chipKIT32/RGB_Station/README.md

# RGB_Station
RGB Station project - remix of Fubarino Mini + addressable LEDs + BLE
