chipKIT32/RGB_Station/board_v12/RGB_Station_v12_BOM_Microchip.xlsx

Sheet: BOM Report
Bill of Materials |  | Bill of Materials For Project RGB Station
Part Number:
Revision: | 1.2
Engineer: | Brian Schmalz
Drawn By: | Brian Schmalz
Creation Date:
Print Date:
Quantity | Designator | Description | Manufacturer 1 | Manufacturer Part Number 1 | Supplier 1 | Supplier Part Number 1 | RoHS compliant? | Supplier Order Qty 1 | Supplier Unit Price 1 | Extension
1 | U4 | OSC MEMS 8.0000MHZ CMOS SMD | Microchip | DSC6111CI1A-008.0000 | Digi-Key | DSC6111CI1A-008.0000-ND | Yes | 1 | $0.88 | $0.88
1 | IC1 | IC REG SOT89 3.3V | Microchip | MCP1702T-3302E/MB | Digi-Key | MCP1702T-3302E/MBCT-ND | Yes | 1 | $0.50 | $0.50
2 | C2, C3 | CAP 1UF 10V CER Y5V SMD 0603 | Kemet | C0603C105Z8VACTU | Digi-Key | 399-3216-1-ND | Yes | 1 | $0.10 | $0.10
3 | C5, C12, C13 | CAP CER 10UF 10V Y5V 0805 | Samsung | CL21F106ZPFNNNE | Digi-Key | 1276-3012-1-ND | Yes | 3 | $0.15 | $0.45
1 | J3 | CONN RCPT USB MICRO B R/A SMT | Wurth Electronics Inc. (https://www.digikey.com/en/supplier-centers/w/wurth-electronics) | 629105136821 | Digi-Key | 732-3155-1-ND | Yes | 1 | $1.21 | $1.21
2 | SW1, SW2 | SWITCH TACTILE SPST-NO 0.05A 32V | C&K Components | KMR221GLFS | Digi-Key | 401-1427-1-ND | Yes | 2 | $0.51 | $1.02
7 | C4, C6, C7, C8, C9, C10, C14 | CAP CER 0.1UF 50V X7R 0603 | Murata | GCJ188R71H104KA12D | Digi-Key | 490-5798-1-ND | Yes | 8 | $0.14 | $1.12
1 | LED1 | LED RED CLEAR 0603 SMD | Dialight | 5988020107F | Digi-Key | 350-2030-1-ND | Yes | 1 | $0.51 | $0.51
1 | LED2 | LED GREEN CLEAR 0603 SMD | Wurth Electronics | 150060GS75000 | Digi-Key | 732-4971-1-ND | Yes | 1 | $0.22 | $0.22
3 | R4,R8,R11 | RES SMD 8.2K OHM 5% 1/10W 0603 | Stackpole | RMCF0603JT8K20 | Digi-Key | RMCF0603JT8K20CT-ND | Yes | 3 | $0.10 | $0.30
3 | R1,R9,R10 | RES 10K OHM 1/10W 5% 0603 SMD | Stackpole | RMCF0603JT10K0 | Digi-Key | RMCF0603JT10K0CT-ND | Yes | 3 | $0.10 | $0.30
1 | U1 | PIC32 USB CPU | Microchip | PIC32MX270F256D-50I/ML | Digi-Key | PIC32MX270F256D-50I/ML-ND | Yes | 1 | $4.69 | $4.69
1 | LED3 | LED BLUE CLEAR 0603 SMD | Wurth Electronics | 150060BS75000 | Digi-Key | 732-4966-1-ND | Yes | 1 | $0.15 | $0.15
1 |  | RGB Station v1.2 blank PCB | SeeedStudios | N.A. | SeeedStudios | N.A. | Yes | 1 |  | $0.00
1 | U2 | IC BUS TRANSCVR 2B N-INV US8 | Texas Instur (https://www.digikey.com/en/supplier-centers/n/nexperia) | SN74LVC2T45DCUR | Digi-Key | 296-17014-1-ND | Yes | 1 | $0.61 | $0.61
1 | U6 | BLUETOOTH 4.2 BLE MODULE, SHIELD | Microchip | RN4871-V/RM118 | Digi-Key | RN4871-V/RM118-ND | Yes | 1 | $7.38 | $7.38
1 | U3 | IC SUPERVISOR 3.08V LOW SOT-23B | Microchip | MCP131T-315E/TT | MicrochipDirect | MCP131T-315E/TTCT-ND | Yes | 1 | $0.53 | $0.53
1 | C11 | CAP ALUM 100UF 20% 10V SMD | Panasonic | EEE-1AA101WR | Digi-Key | PCE3867CT-ND | Yes | 1 | $0.31 | $0.31
2 | R2, R3 | RES SMD 100 OHM 5% 1/10W 0603 | Stackpole | RMCF0603JT100R | Digi-Key | RMCF0603JT100RCT-ND | Yes | 2 | $0.10 | $0.20
DO NOT POPULATE ANY PARTS BELOW THIS LINE
0 | J7 | 4-pin .100" header
0 | J1, J2 | 20-pin .100" header
0 | J6 | CONN TERM BLOCK T/H 2POS 3.5MM | Phoenix Contact | 1984617 | Digi-Key | 277-1721-ND | Yes | 1 | $0.43 | $0.43
0 | J5 | CONN TERM BLOCK T/H 4POS 3.5MM | Phoenix Contact | 1984633 | Digi-Key | 277-1860-ND | Yes | 1 | $0.85 | $0.85
0 | J3 | 5-pin .100" header
 |  |  |  |  |  |  |  |  |  | $21.76
Approved | Notes

Sheet: Project Information
Project Full Path
Project Filename
Variant Name
Data-Source Filename
Data-Source Full Path
Title
Total Quantity
Report Time
Report Date
Report Date & Tine
Output Name
Output Type
Output Generator Name
Output Generator Description

Sheet: Compatibility Report
Compatibility Report for RGB_Station_v10_BOM_Microchip.xls
Run on 11/17/2017 3:42
If the workbook is saved in an earlier file format or opened in an earlier version of Microsoft Excel, the listed features will not be available.
Minor loss of fidelity | # of occurrences | Version
Some cells or styles in this workbook contain formatting that is not supported by the selected file format. These formats will be converted to the closest format available. | 1 | Excel 97-2003
