chipKIT32/RGB_Station/docs/RGB_station_PinDiagram_v12.pdf

# RGB Station v1.2 pins

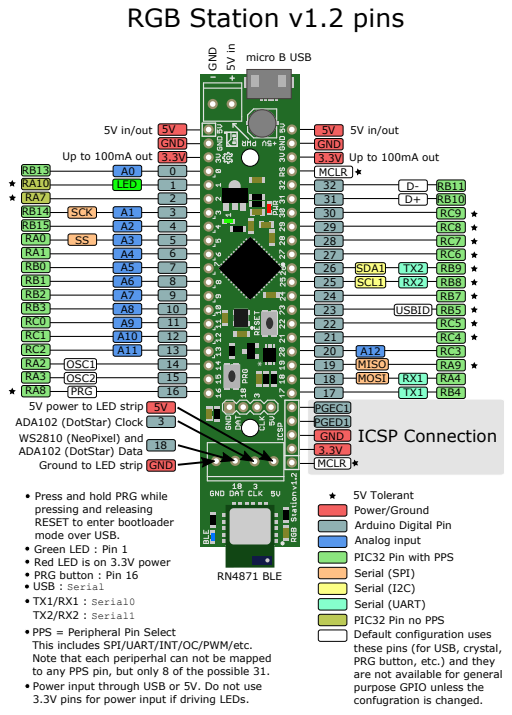
[picture p1: page 1]
micro B USB; ICSP Connection; GND; MCLR 32 31 30 29 28 27 26 25 24 23 22 21 20 19 18 17; SCK; OSC1 OSC2 PRG; MOSI; MISO; USBID; SDA1; SCL1; 5V in/out; Up to 100mA out; MCLR; PGED1; PGEC1; LED; 5V power to LED strip 5V; Ground to LED strip; ADA102 (DotStar) Clock WS2810 (NeoPixel) and ADA102 (DotStar) Data; RN4871 BLE

Up to 100mA out

Press and hold PRG while
pressing and releasing
RESET to enter bootloader
mode over USB.
Green LED : Pin 1
Red LED is on 3.3V power
PRG button : Pin 16
USB : Serial
TX1/RX1 : Serial0
TX2/RX2 : Serial1
PPS = Peripheral Pin Select
This includes SPI/UART/INT/OC/PWM/etc.
Note that each periperhal can not be mapped
to any PPS pin, but only 8 of the possible 31.
Power input through USB or 5V. Do not use
3.3V pins for power input if driving LEDs.

5V Tolerant
Power/Ground
Arduino Digital Pin
Analog input
PIC32 Pin with PPS
Serial (SPI)
Serial (I2C)
Serial (UART)
PIC32 Pin no PPS
Default configuration uses
these pins (for USB, crystal,
PRG button, etc.) and they
are not available for general
purpose GPIO unless the
confugration is changed.
