chipKIT32/RGB_Station/board_v12/RGB_Station_v12_sch.pdf

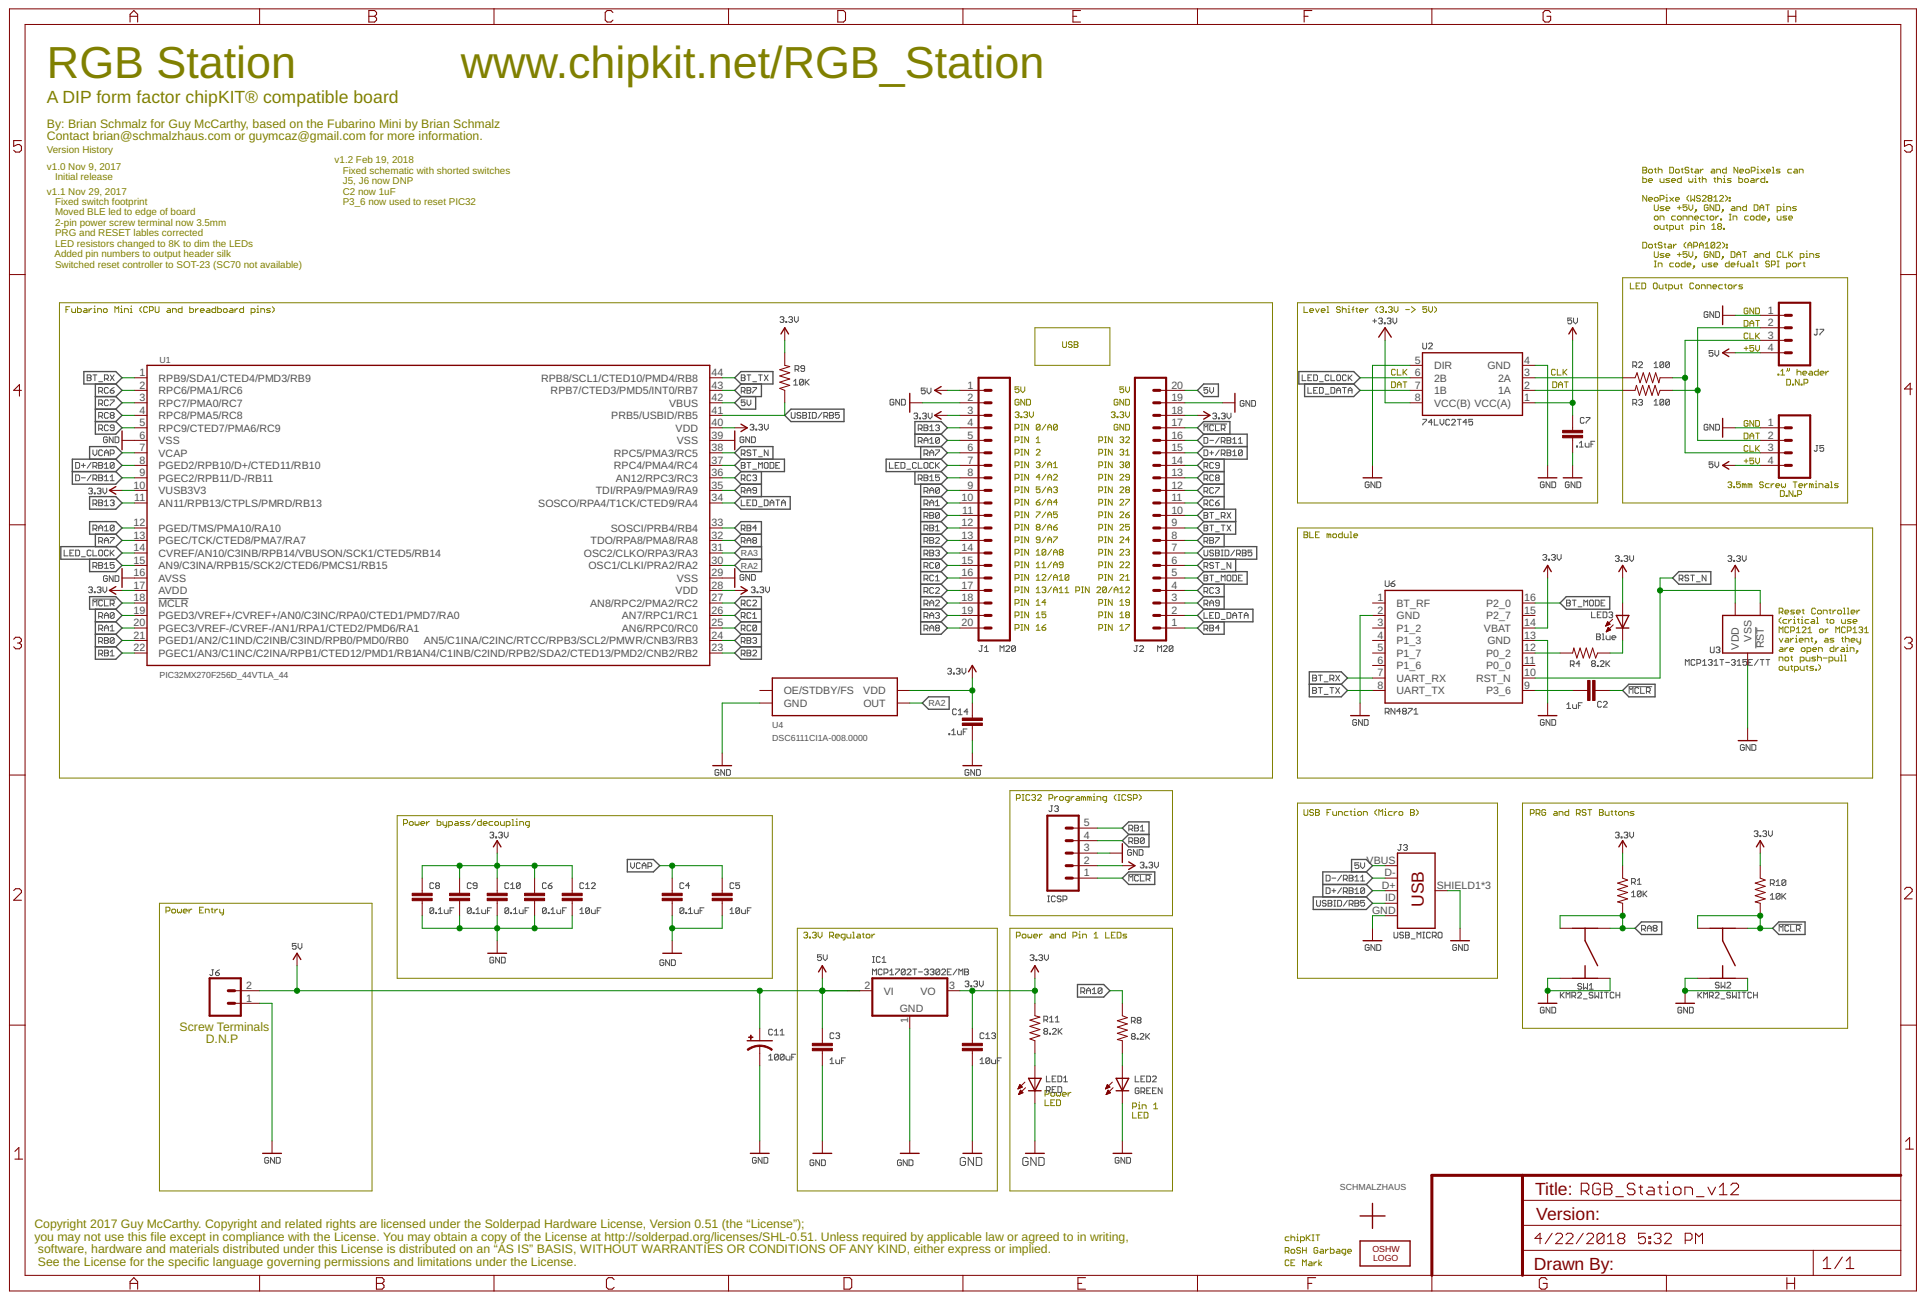
[picture p2: page 1]

Initial release Version History A DIP form factor chipKIT® compatible board

By: Brian Schmalz for Guy McCarthy, based on the Fubarino Mini by Brian Schmalz Contact brian@schmalzhaus.com or guymcaz@gmail.com for more information. v1.0 Nov 9, 2017

v1.2 Feb 19, 2018 Fixed schematic with shorted switches

v1.1 Nov 29, 2017 Fixed switch footprint Moved BLE led to edge of board

J5, J6 now DNP C2 now 1uF P3_6 now used to reset PIC32

2-pin power screw terminal now 3.5mm
PRG and RESET lables corrected
LED resistors changed to 8K to dim the LEDs Added pin numbers to output header silk Switched reset controller to SOT-23 (SC70 not available)

Drawn By: Title: Version: OSHW

Copyright 2017 Guy McCarthy. Copyright and related rights are licensed under the Solderpad Hardware License, Version 0.51 (the “License”); you may not use this file except in compliance with the License. You may obtain a copy of the License at http://solderpad.org/licenses/SHL-0.51. Unless required by applicable law or agreed to in writing, software, hardware and materials distributed under this License is distributed on an “AS IS” BASIS, WITHOUT WARRANTIES OR CONDITIONS OF ANY KIND, either express or implied. See the License for the specific language governing permissions and limitations under the License.
