chipKIT32/RGB_Station/docs/RGB_Station_v12_brd.pdf

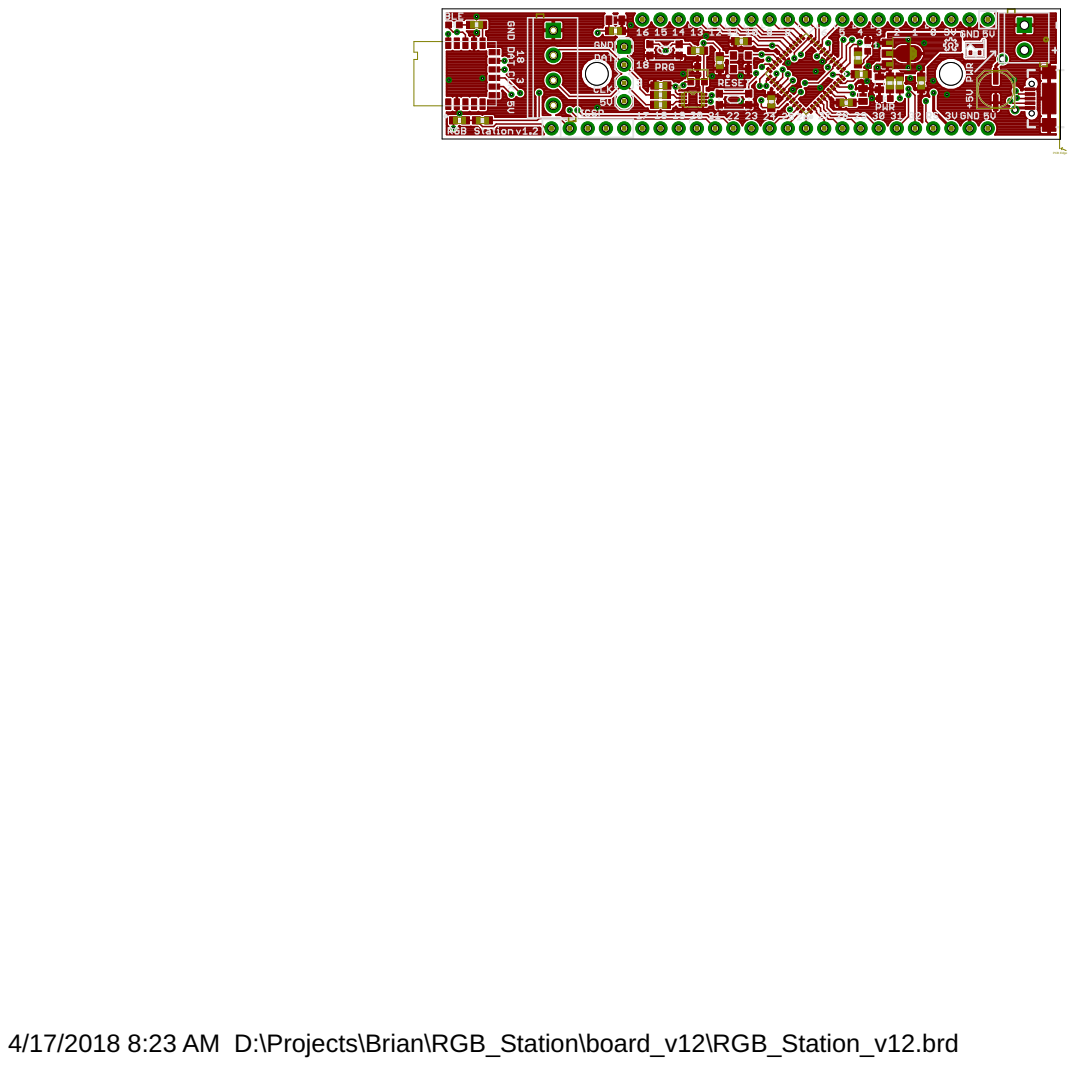
[picture p3: page 1]

4/17/2018 8:23 AM D:\Projects\Brian\RGB_Station\board_v12\RGB_Station_v12.brd
