chipKIT32/RGB_Station/board_v11/RGB_Station_v11.pdf

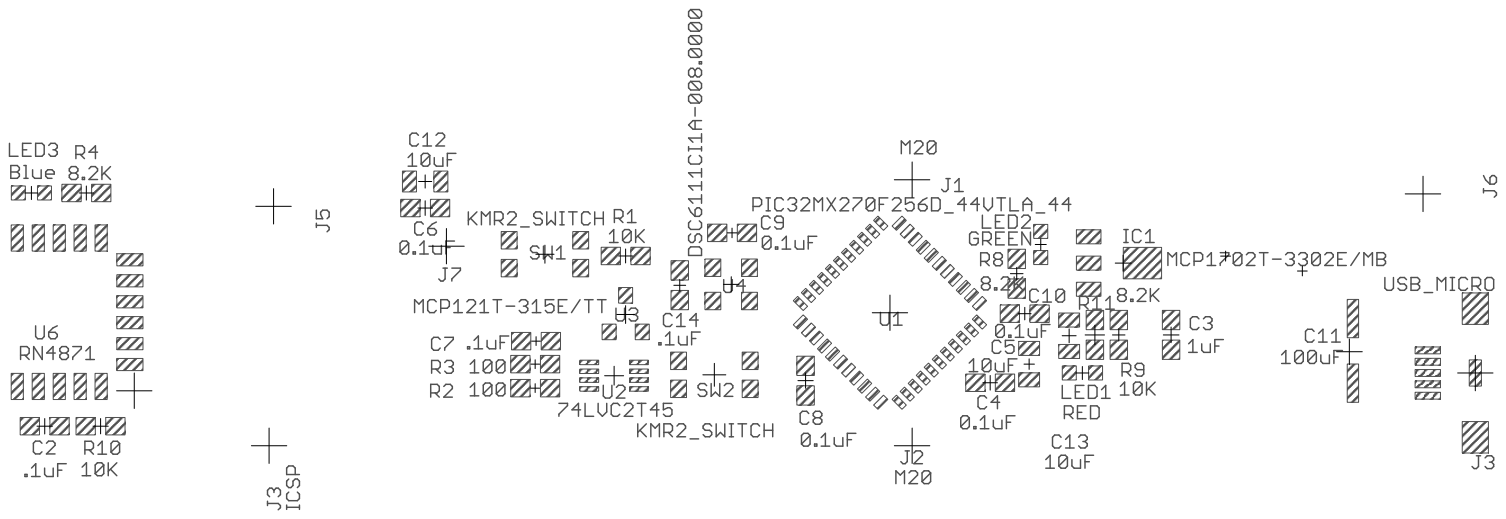
[picture p4: page 1]
