chipKIT32/RGB_Station/board_v10/RGB_Station_v10_brd.pdf

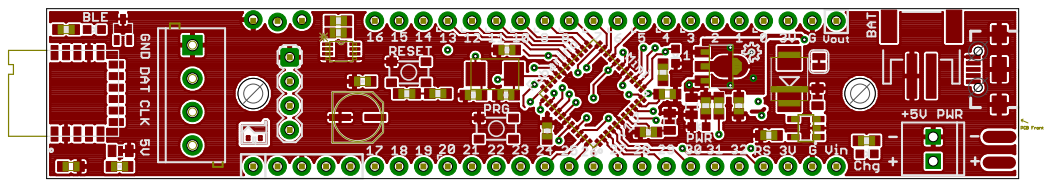
[picture p5: page 1]
