chipKIT32/RGB_Station/board_v12/RGB_Station_v12.brd

## EAGLE design board_v12/RGB_Station_v12.brd (2018-03-15)

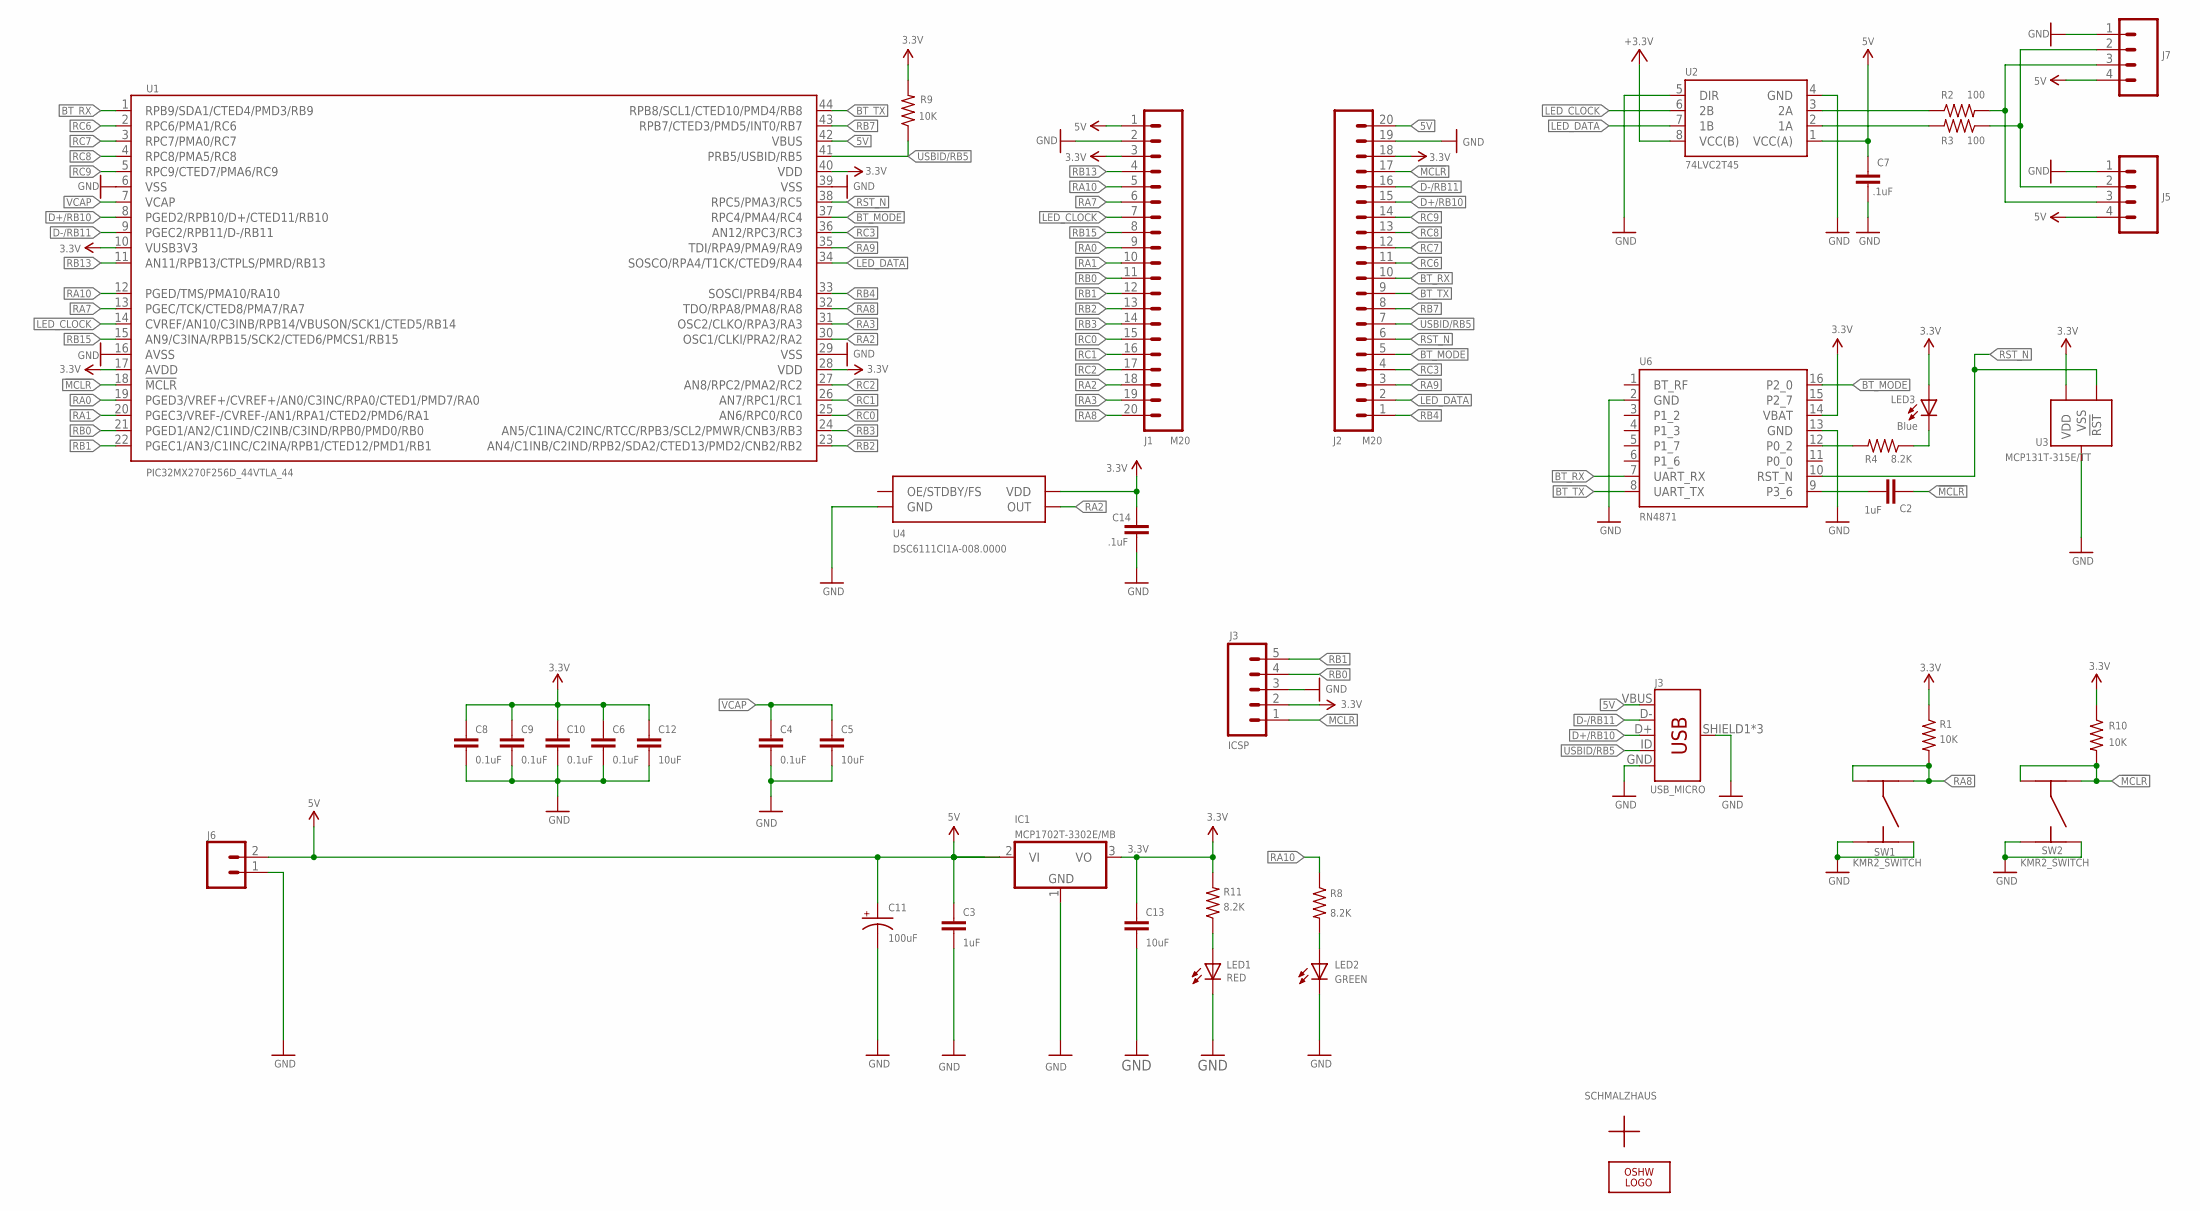
[picture p6: schematic RGB_Station_v12.sch]

Parts:
C2, C3: 1uF; 0603-CAP
C4, C8, C9: 0.1uF; 0603-CAP
C5, C12, C13: 10uF; 0805
C6, C10: 0.1uF; 0603
C7, C14: .1uF; 0603-CAP
C11: 100uF; PANASONIC_C
IC1: MCP1702T-3302E/MB; RGB_STATION_V12_LINEAR_SOT89
ICSP: J3; 1X05_NOSILK
J1, J2: M20; 1X20_NO_PIN1
J3: USB_MICRO; SPARKFUN-CONNECTORS_USB-B-MICRO-SMD
J5: CONN_04SCREW; SCREWTERMINAL-3.5MM-4@1
J6: CONN_023.5MM; SCREWTERMINAL-3.5MM-2
J7: M04PTH; 1X04
LED1: RED; LED-0603
LED2: GREEN; LED-0603
LED3: Blue; LED-0603
LOGO1: OSHW_LOGO_8MILX0070-NT; OSHW_8X70_NOTEXT
R1, R9, R10: 10K; 0603-RES
R2, R3: 100; 0603-RES
R4, R8, R11: 8.2K; 0603-RES
SW1, SW2: KMR2_SWITCH
U1: PIC32MX270F256D_44VTLA_44; QFN-44-8X8-NOPAD
U2: 74LVC2T45; VSSOP8
U3: MCP131T-315E/TT; SOT23-3
U4: DSC6111CI1A-008.0000; CDFN-4_3.2X2.5
U6: RN4871
U$2: CE_MARK5MM; CE_5MM
U$3: ROSH_GARBAGE; ROHS_GARBAGE_5MM
U$4: CHIPKIT2MM; CHIPKIT_2MM
U$5: SCHMALZHAUSSCHMALZHAUS_SMALL; SCHMALZHAUS_SMALL

Connections:
3.3V: C6.1, C8.1, C9.1, C10.1, C12.1, C13.1, C14.2, IC1.3 (VO), ICSP.2, J1.3, J2.18, LED3.A, R1.1, R9.2, R10.1, R11.2, U1.10 (VUSB3V3), U1.17 (AVDD), U1.28 (VDD), U1.40 (VDD), U2.8 (VCC(B)), U3.2 (VDD), U4.P4 (VDD), U6.14 (VBAT)
5V: C3.1, C7.2, C11.+, IC1.2 (VI), IC1.2@1 (VI1), J1.1, J2.20, J3.VBUS, J5.4, J6.2, J7.4, U1.42 (VBUS), U2.1 (VCC(A))
!MCLR!: C2.2, ICSP.1, J2.17, R10.2, SW2.P1, SW2.P4, U1.18 (!MCLR!)
BT_MODE: J2.5, U1.37 (RPC4/PMA4/RC4), U6.16 (P2_0)
BT_RX: J2.10, U1.1 (RPB9/SDA1/CTED4/PMD3/RB9), U6.7 (UART_RX)
BT_TX: J2.9, U1.44 (RPB8/SCL1/CTED10/PMD4/RB8), U6.8 (UART_TX)
D+/RB10: J2.15, J3.D+, U1.8 (PGED2/RPB10/D+/CTED11/RB10)
D-/RB11: J2.16, J3.D-, U1.9 (PGEC2/RPB11/D-/RB11)
GND: C3.2, C4.2, C5.2, C6.2, C7.1, C8.2, C9.2, C10.2, C11.-, C12.2, C13.2, C14.1, IC1.1 (GND), ICSP.3, J1.2, J2.19, J3.GND, J3.SHIELD1 (SHIELD), J3.SHIELD2 (SHIELD), J3.SHIELD3 (SHIELD), J5.1, J6.1, J7.1, LED1.C, LED2.C, SW1.P2, SW1.P3, SW2.P2, SW2.P3, U1.6 (VSS), U1.16 (AVSS), U1.29 (VSS), U1.39 (VSS), U2.4 (GND), U2.5 (DIR), U3.3 (VSS), U4.P2 (GND), U6.2 (GND), U6.13 (GND)
LED_CLOCK: J1.7, U1.14 (CVREF/AN10/C3INB/RPB14/VBUSON/SCK1/CTED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), U2.6 (2B)
LED_DATA: J2.2, U1.34 (SOSCO/RPA4/T1CK/CTED9/RA4), U2.7 (1B)
unnamed: R4.2, U6.12 (P0_2)
unnamed: J5.2, J7.2, R3.1
unnamed: R3.2, U2.2 (1A)
unnamed: J5.3, J7.3, R2.2
unnamed: LED3.C, R4.1
unnamed: LED1.A, R11.1
unnamed: C2.1, U6.9 (P3_6)
unnamed: LED2.A, R8.2
unnamed: R2.1, U2.3 (2A)
RA0: J1.9, U1.19 (PGED3/VREF+/CVREF+/AN0/C3INC/RPA0/CTED1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)
RA1: J1.10, U1.20 (PGEC3/VREF-/CVREF-/AN1/RPA1/CTED2/PMD6/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)
RA2: J1.18, U1.30 (OSC1/CLKI/PRA2/RA2), U4.P3 (OUT)
RA3: J1.19, U1.31 (OSC2/CLKO/RPA3/RA3)
RA7: J1.6, U1.13 (PGEC/TCK/CTED8/PMA7/RA7)
RA8: J1.20, R1.2, SW1.P1, SW1.P4, U1.32 (TDO/RPA8/PMA8/RA8)
RA9: J2.3, U1.35 (TDI/RPA9/PMA9/RA9)
RA10: J1.5, R8.1, U1.12 (PGED/TMS/PMA10/RA10)
RB0: ICSP.4, J1.11, U1.21 (PGED1/AN2/C1IND/C2INB/C3IND/RPB0/PMD0/R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)
RB1: ICSP.5, J1.12, U1.22 (PGEC1/AN3/C1INC/C2INA/RPB1/CTED12/PMD1/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)
RB2: J1.13, U1.23 (AN4/C1INB/C2IND/RPB2/SDA2/CTED13/PMD2/C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)
RB3: J1.14, U1.24 (AN5/C1INA/C2INC/RTCC/RPB3/SCL2/PMWR/CNB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)
RB4: J2.1, U1.33 (SOSCI/PRB4/RB4)
RB7: J2.8, U1.43 (RPB7/CTED3/PMD5/INT0/RB7)
RB13: J1.4, U1.11 (AN11/RPB13/CTPLS/PMRD/RB13)
RB15: J1.8, U1.15 (AN9/C3INA/RPB15/SCK2/CTED6/PMCS1/RB15)
RC0: J1.15, U1.25 (AN6/RPC0/RC0)
RC1: J1.16, U1.26 (AN7/RPC1/RC1)
RC2: J1.17, U1.27 (AN8/RPC2/PMA2/RC2)
RC3: J2.4, U1.36 (AN12/RPC3/RC3)
RC6: J2.11, U1.2 (RPC6/PMA1/RC6)
RC7: J2.12, U1.3 (RPC7/PMA0/RC7)
RC8: J2.13, U1.4 (RPC8/PMA5/RC8)
RC9: J2.14, U1.5 (RPC9/CTED7/PMA6/RC9)
RST_N: J2.6, U1.38 (RPC5/PMA3/RC5), U3.1 (!RST!), U6.10 (RST_N)
USBID/RB5: J2.7, J3.ID, R9.1, U1.41 (PRB5/USBID/RB5)
VCAP: C4.1, C5.1, U1.7 (VCAP)

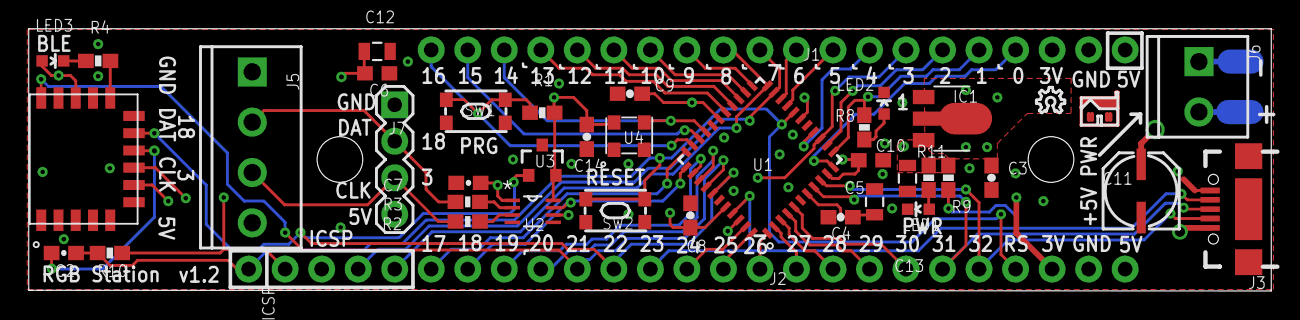
[picture p7: board RGB_Station_v12.brd from above]

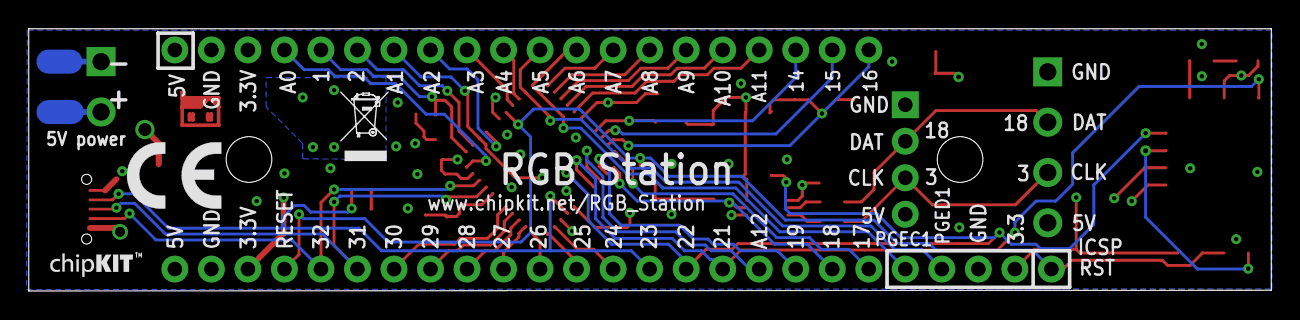
[picture p8: board RGB_Station_v12.brd from below]

Board: 4 copper layers, 86.4 x 18.2 mm, 44 parts (3 on the bottom side), 47 nets.
