chipKIT32/RGB_Station/board_v11/RGB_Station_v11_pannel.brd

## EAGLE design board_v11/RGB_Station_v11_pannel.brd (2017-12-03, an earlier design)

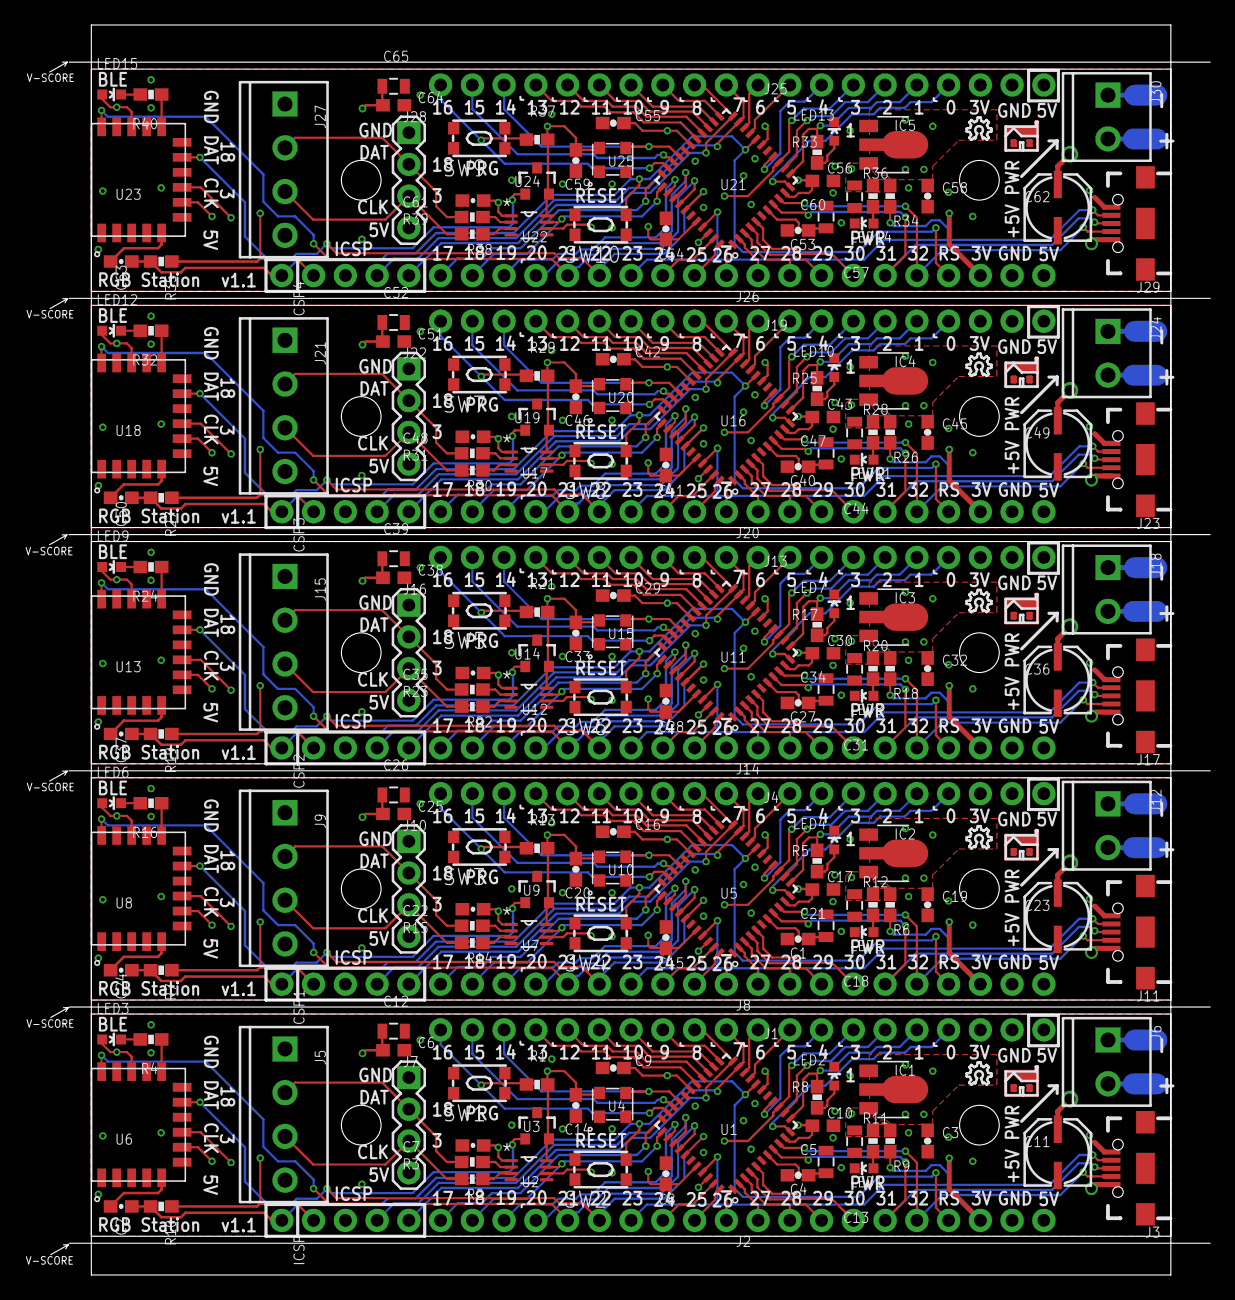
[picture p9: board RGB_Station_v11_pannel.brd from above]

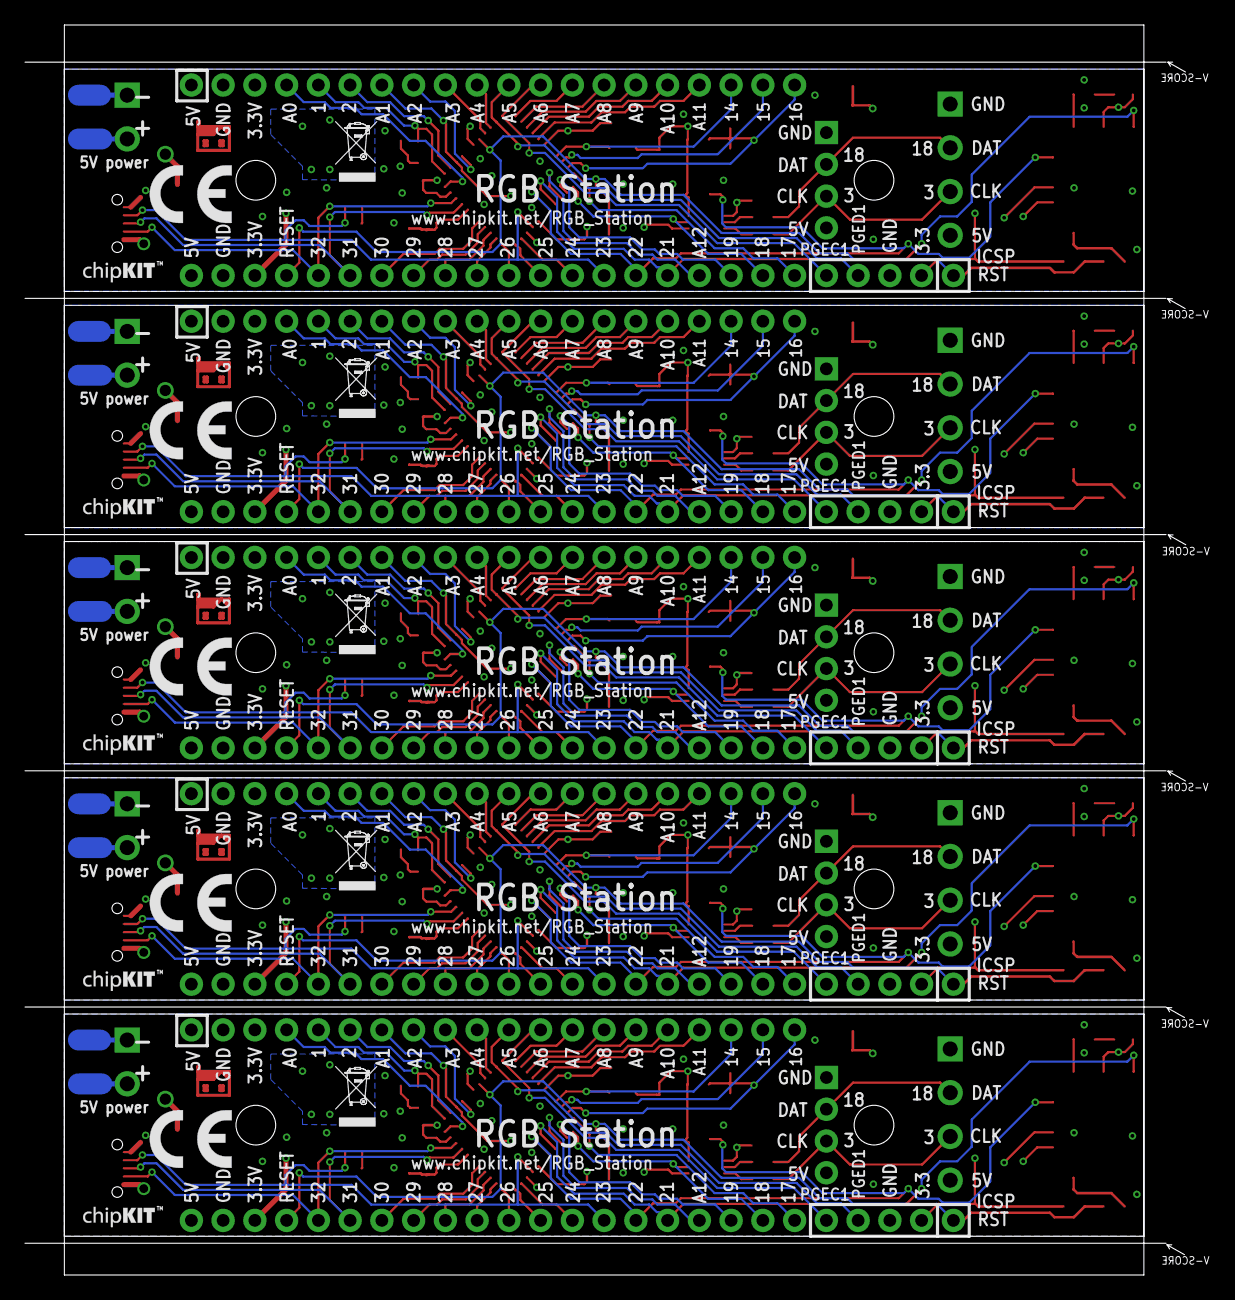
[picture p10: board RGB_Station_v11_pannel.brd from below]

Board: 4 copper layers, 92.9 x 100.0 mm, 220 parts (15 on the bottom side), 235 nets.

Parts:
C1, C4, C8, C9, C15, C16, C27, C28, C29, C40, C41, C42, C53, C54, C55: 0.1uF; 0603-CAP
C2, C7, C14, C20, C22, C24, C33, C35, C37, C46, C48, C50, C59, C61, C63: .1uF; 0603-CAP
C3, C19, C32, C45, C58: 1uF; 0603-CAP
C5, C12, C13, C18, C21, C26, C31, C34, C39, C44, C47, C52, C57, C60, C65: 10uF; 0805
C6, C10, C17, C25, C30, C38, C43, C51, C56, C64: 0.1uF; 0603
C11, C23, C36, C49, C62: 100uF; PANASONIC_C
IC1, IC2, IC3, IC4, IC5: MCP1702T-3302E/MB; SOT89
ICSP, ICSP1, ICSP2, ICSP3, ICSP4: J3; 1X05_NOSILK
J1, J2, J4, J8, J13, J14, J19, J20, J25, J26: M20; 1X20_NO_PIN1
J3, J11, J17, J23, J29: USB_MICRO; USB-B-MICRO-SMD
J5, J9, J15, J21, J27: SCREWTERMINAL-3.5MM-4@1
J6, J12, J18, J24, J30: SCREWTERMINAL-3.5MM-2
J7, J10, J16, J22, J28: 1X04
LED1, LED5, LED8, LED11, LED14: RED; LED-0603
LED2, LED4, LED7, LED10, LED13: GREEN; LED-0603
LED3, LED6, LED9, LED12, LED15: Blue; LED-0603
LOGO1, LOGO2, LOGO3, LOGO4, LOGO5: OSHW_LOGO_8MILX0070-NT; OSHW_8X70_NOTEXT
R1, R6, R7, R9, R10, R13, R18, R19, R21, R26, R27, R29, R34, R35, R37: 10K; 0603-RES
R2, R3, R14, R15, R22, R23, R30, R31, R38, R39: 100; 0603-RES
R4, R5, R8, R11, R12, R16, R17, R20, R24, R25, R28, R32, R33, R36, R40: 8.2K; 0603-RES
SW1, SW2, SW3, SW4, SW5, SW6, SW7, SW8, SW9, SW10: KMR2_SWITCH
U1, U5, U11, U16, U21: PIC32MX270F256D_44VTLA_44; QFN-44-8X8-NOPAD
U2, U7, U12, U17, U22: 74LVC2T45; VSSOP8
U3, U9, U14, U19, U24: MCP121T-315E/TT; SOT23-3
U4, U10, U15, U20, U25: DSC6111CI1A-008.0000; CDFN-4_3.2X2.5
U6, U8, U13, U18, U23: RN4871
U$1, U$2, U$9, U$13, U$17: CE_MARK5MM; CE_5MM
U$3, U$6, U$10, U$14, U$18: ROSH_GARBAGE; ROHS_GARBAGE_5MM
U$4, U$7, U$11, U$15, U$19: CHIPKIT2MM; CHIPKIT_2MM
U$5, U$8, U$12, U$16, U$20: SCHMALZHAUSSCHMALZHAUS_SMALL; SCHMALZHAUS_SMALL

Connections:
3.3V: C6.1, C8.1, C9.1, C10.1, C12.1, C13.1, C14.2, IC1.3, ICSP.2, J1.3, J2.18, LED3.A, R1.1, R9.2, R10.1, R11.2, U1.10, U1.17, U1.28, U1.40, U2.8, U3.2, U4.P4, U6.14
3.3V1: C15.1, C16.1, C17.1, C18.1, C20.2, C25.1, C26.1, IC2.3, ICSP1.2, J4.3, J8.18, LED6.A, R6.2, R7.1, R12.2, R13.1, U5.10, U5.17, U5.28, U5.40, U7.8, U8.14, U9.2, U10.P4
3.3V2: C28.1, C29.1, C30.1, C31.1, C33.2, C38.1, C39.1, IC3.3, ICSP2.2, J13.3, J14.18, LED9.A, R18.2, R19.1, R20.2, R21.1, U11.10, U11.17, U11.28, U11.40, U12.8, U13.14, U14.2, U15.P4
3.3V3: C41.1, C42.1, C43.1, C44.1, C46.2, C51.1, C52.1, IC4.3, ICSP3.2, J19.3, J20.18, LED12.A, R26.2, R27.1, R28.2, R29.1, U16.10, U16.17, U16.28, U16.40, U17.8, U18.14, U19.2, U20.P4
3.3V4: C54.1, C55.1, C56.1, C57.1, C59.2, C64.1, C65.1, IC5.3, ICSP4.2, J25.3, J26.18, LED15.A, R34.2, R35.1, R36.2, R37.1, U21.10, U21.17, U21.28, U21.40, U22.8, U23.14, U24.2, U25.P4
5V: C3.1, C7.2, C11.+, IC1.2, IC1.2@1, J1.1, J2.20, J3.VBUS, J5.4, J6.2, J7.4, U1.42, U2.1
5V1: C19.1, C22.2, C23.+, IC2.2, IC2.2@1, J4.1, J8.20, J9.4, J10.4, J11.VBUS, J12.2, U5.42, U7.1
5V2: C32.1, C35.2, C36.+, IC3.2, IC3.2@1, J13.1, J14.20, J15.4, J16.4, J17.VBUS, J18.2, U11.42, U12.1
5V3: C45.1, C48.2, C49.+, IC4.2, IC4.2@1, J19.1, J20.20, J21.4, J22.4, J23.VBUS, J24.2, U16.42, U17.1
5V4: C58.1, C61.2, C62.+, IC5.2, IC5.2@1, J25.1, J26.20, J27.4, J28.4, J29.VBUS, J30.2, U21.42, U22.1
!MCLR!: C2.2, ICSP.1, J2.17, R10.2, SW2.P3, SW2.P4, U1.18
!MCLR!1: C24.2, ICSP1.1, J8.17, R7.2, SW4.P3, SW4.P4, U5.18
!MCLR!2: C37.2, ICSP2.1, J14.17, R19.2, SW6.P3, SW6.P4, U11.18
!MCLR!3: C50.2, ICSP3.1, J20.17, R27.2, SW8.P3, SW8.P4, U16.18
!MCLR!4: C63.2, ICSP4.1, J26.17, R35.2, SW10.P3, SW10.P4, U21.18
BT_MODE: J2.5, U1.37, U6.16
BT_MODE1: J8.5, U5.37, U8.16
BT_MODE2: J14.5, U11.37, U13.16
BT_MODE3: J20.5, U16.37, U18.16
BT_MODE4: J26.5, U21.37, U23.16
BT_RX: J2.10, U1.1, U6.7
BT_RX1: J8.10, U5.1, U8.7
BT_RX2: J14.10, U11.1, U13.7
BT_RX3: J20.10, U16.1, U18.7
BT_RX4: J26.10, U21.1, U23.7
BT_TX: J2.9, U1.44, U6.8
BT_TX1: J8.9, U5.44, U8.8
BT_TX2: J14.9, U11.44, U13.8
BT_TX3: J20.9, U16.44, U18.8
BT_TX4: J26.9, U21.44, U23.8
D+/RB1: J8.15, J11.D+, U5.8
D+/RB2: J14.15, J17.D+, U11.8
D+/RB3: J20.15, J23.D+, U16.8
D+/RB4: J26.15, J29.D+, U21.8
D+/RB10: J2.15, J3.D+, U1.8
D-/RB1: J8.16, J11.D-, U5.9
D-/RB2: J14.16, J17.D-, U11.9
D-/RB3: J20.16, J23.D-, U16.9
D-/RB4: J26.16, J29.D-, U21.9
D-/RB11: J2.16, J3.D-, U1.9
GND: C3.2, C4.2, C5.2, C6.2, C7.1, C8.2, C9.2, C10.2, C11.-, C12.2, C13.2, C14.1, IC1.1, ICSP.3, J1.2, J2.19, J3.GND, J3.SHIELD1, J3.SHIELD2, J3.SHIELD3, J5.1, J6.1, J7.1, LED1.C, LED2.C, SW1.P1, SW1.P2, SW2.P1, SW2.P2, U1.6, U1.16, U1.29, U1.39, U2.4, U2.5, U3.3, U4.P2, U6.2, U6.13
GND1: C1.2, C15.2, C16.2, C17.2, C18.2, C19.2, C20.1, C21.2, C22.1, C23.-, C25.2, C26.2, IC2.1, ICSP1.3, J4.2, J8.19, J9.1, J10.1, J11.GND, J11.SHIELD1, J11.SHIELD2, J11.SHIELD3, J12.1, LED4.C, LED5.C, SW3.P1, SW3.P2, SW4.P1, SW4.P2, U5.6, U5.16, U5.29, U5.39, U7.4, U7.5, U8.2, U8.13, U9.3, U10.P2
GND2: C27.2, C28.2, C29.2, C30.2, C31.2, C32.2, C33.1, C34.2, C35.1, C36.-, C38.2, C39.2, IC3.1, ICSP2.3, J13.2, J14.19, J15.1, J16.1, J17.GND, J17.SHIELD1, J17.SHIELD2, J17.SHIELD3, J18.1, LED7.C, LED8.C, SW5.P1, SW5.P2, SW6.P1, SW6.P2, U11.6, U11.16, U11.29, U11.39, U12.4, U12.5, U13.2, U13.13, U14.3, U15.P2
GND3: C40.2, C41.2, C42.2, C43.2, C44.2, C45.2, C46.1, C47.2, C48.1, C49.-, C51.2, C52.2, IC4.1, ICSP3.3, J19.2, J20.19, J21.1, J22.1, J23.GND, J23.SHIELD1, J23.SHIELD2, J23.SHIELD3, J24.1, LED10.C, LED11.C, SW7.P1, SW7.P2, SW8.P1, SW8.P2, U16.6, U16.16, U16.29, U16.39, U17.4, U17.5, U18.2, U18.13, U19.3, U20.P2
GND4: C53.2, C54.2, C55.2, C56.2, C57.2, C58.2, C59.1, C60.2, C61.1, C62.-, C64.2, C65.2, IC5.1, ICSP4.3, J25.2, J26.19, J27.1, J28.1, J29.GND, J29.SHIELD1, J29.SHIELD2, J29.SHIELD3, J30.1, LED13.C, LED14.C, SW9.P1, SW9.P2, SW10.P1, SW10.P2, U21.6, U21.16, U21.29, U21.39, U22.4, U22.5, U23.2, U23.13, U24.3, U25.P2
LED_CLOCK: J1.7, U1.14, U2.6
LED_CLOCK1: J4.7, U5.14, U7.6
LED_CLOCK2: J13.7, U11.14, U12.6
LED_CLOCK3: J19.7, U16.14, U17.6
LED_CLOCK4: J25.7, U21.14, U22.6
LED_DATA: J2.2, U1.34, U2.7
LED_DATA1: J8.2, U5.34, U7.7
LED_DATA2: J14.2, U11.34, U12.7
LED_DATA3: J20.2, U16.34, U17.7
LED_DATA4: J26.2, U21.34, U22.7
unnamed: R4.2, U6.12
unnamed: J5.2, J7.2, R3.1
unnamed: R3.2, U2.2
unnamed: J5.3, J7.3, R2.2
unnamed: LED3.C, R4.1
unnamed: LED1.A, R11.1
unnamed: LED5.A, R12.1
unnamed: C2.1, U6.5
unnamed: J9.3, J10.3, R14.2
unnamed: R14.1, U7.3
unnamed: LED2.A, R8.2
unnamed: J9.2, J10.2, R15.1
unnamed: R15.2, U7.2
unnamed: C24.1, U8.5
unnamed: LED4.A, R5.2
unnamed: R16.2, U8.12
unnamed: LED6.C, R16.1
unnamed: LED8.A, R20.1
unnamed: J15.3, J16.3, R22.2
unnamed: R22.1, U12.3
unnamed: J15.2, J16.2, R23.1
unnamed: R23.2, U12.2
unnamed: R2.1, U2.3
unnamed: C37.1, U13.5
unnamed: LED7.A, R17.2
unnamed: R24.2, U13.12
unnamed: LED9.C, R24.1
unnamed: LED11.A, R28.1
unnamed: J21.3, J22.3, R30.2
unnamed: R30.1, U17.3
unnamed: J21.2, J22.2, R31.1
unnamed: R31.2, U17.2
unnamed: C50.1, U18.5
unnamed: LED10.A, R25.2
unnamed: R32.2, U18.12
unnamed: LED12.C, R32.1
unnamed: LED14.A, R36.1
unnamed: J27.3, J28.3, R38.2
unnamed: R38.1, U22.3
unnamed: J27.2, J28.2, R39.1
unnamed: R39.2, U22.2
unnamed: C63.1, U23.5
unnamed: LED13.A, R33.2
unnamed: R40.2, U23.12
unnamed: LED15.C, R40.1
RA0: J1.9, U1.19
RA1: J1.10, U1.20
RA2: J1.18, U1.30, U4.P3
RA3: J1.19, U1.31
RA4: J4.19, U5.31
RA5: J4.18, U5.30, U10.P3
RA6: J8.3, U5.35
RA7: J1.6, U1.13
RA8: J1.20, R1.2, SW1.P3, SW1.P4, U1.32
RA9: J2.3, U1.35
RA10: J1.5, R8.1, U1.12
RA11: J4.20, R13.2, SW3.P3, SW3.P4, U5.32
RA12: J4.5, R5.1, U5.12
RA13: J4.6, U5.13
RA14: J4.9, U5.19
RA15: J4.10, U5.20
RA16: J13.19, U11.31
RA17: J13.18, U11.30, U15.P3
RA18: J14.3, U11.35
RA19: J13.20, R21.2, SW5.P3, SW5.P4, U11.32
RA20: J13.5, R17.1, U11.12
RA21: J13.6, U11.13
RA22: J13.9, U11.19
RA23: J13.10, U11.20
RA24: J19.19, U16.31
RA25: J19.18, U16.30, U20.P3
RA26: J20.3, U16.35
RA27: J19.20, R29.2, SW7.P3, SW7.P4, U16.32
RA28: J19.5, R25.1, U16.12
RA29: J19.6, U16.13
RA30: J19.9, U16.19
RA31: J19.10, U16.20
RA32: J25.19, U21.31
RA33: J25.18, U21.30, U25.P3
RA34: J26.3, U21.35
RA35: J25.20, R37.2, SW9.P3, SW9.P4, U21.32
RA36: J25.5, R33.1, U21.12
RA37: J25.6, U21.13
RA38: J25.9, U21.19
RA39: J25.10, U21.20
RB0: ICSP.4, J1.11, U1.21
RB1: ICSP.5, J1.12, U1.22
RB2: J1.13, U1.23
RB3: J1.14, U1.24
RB4: J2.1, U1.33
RB5: J4.4, U5.11
RB6: J4.8, U5.15
RB7: J2.8, U1.43
RB8: ICSP1.5, J4.12, U5.22
RB9: ICSP1.4, J4.11, U5.21
RB10: J8.8, U5.43
RB11: J4.14, U5.24
RB12: J4.13, U5.23
RB13: J1.4, U1.11
RB14: J8.1, U5.33
RB15: J1.8, U1.15
RB16: J13.4, U11.11
RB17: J13.8, U11.15
RB18: ICSP2.5, J13.12, U11.22
RB19: ICSP2.4, J13.11, U11.21
RB20: J14.8, U11.43
RB21: J13.14, U11.24
RB22: J13.13, U11.23
RB23: J14.1, U11.33
RB24: J19.4, U16.11
RB25: J19.8, U16.15
RB26: ICSP3.5, J19.12, U16.22
RB27: ICSP3.4, J19.11, U16.21
RB28: J20.8, U16.43
RB29: J19.14, U16.24
RB30: J19.13, U16.23
RB31: J20.1, U16.33
RB32: J25.4, U21.11
RB33: J25.8, U21.15
RB34: ICSP4.5, J25.12, U21.22
RB35: ICSP4.4, J25.11, U21.21
RB36: J26.8, U21.43
RB37: J25.14, U21.24
RB38: J25.13, U21.23
RB39: J26.1, U21.33
RC0: J1.15, U1.25
RC1: J1.16, U1.26
RC2: J1.17, U1.27
RC3: J2.4, U1.36
RC4: J8.4, U5.36
RC5: J4.17, U5.27
RC6: J2.11, U1.2
RC7: J2.12, U1.3
RC8: J2.13, U1.4
RC9: J2.14, U1.5
RC10: J4.16, U5.26
RC11: J4.15, U5.25
RC12: J8.11, U5.2
RC13: J8.12, U5.3
RC14: J8.13, U5.4
RC15: J8.14, U5.5
RC16: J14.4, U11.36
RC17: J13.17, U11.27
RC18: J13.16, U11.26
RC19: J13.15, U11.25
RC20: J14.11, U11.2
RC21: J14.12, U11.3
RC22: J14.13, U11.4
RC23: J14.14, U11.5
RC24: J20.4, U16.36
RC25: J19.17, U16.27
RC26: J19.16, U16.26
RC27: J19.15, U16.25
RC28: J20.11, U16.2
RC29: J20.12, U16.3
RC30: J20.13, U16.4
RC31: J20.14, U16.5
RC32: J26.4, U21.36
RC33: J25.17, U21.27
RC34: J25.16, U21.26
RC35: J25.15, U21.25
RC36: J26.11, U21.2
RC37: J26.12, U21.3
RC38: J26.13, U21.4
RC39: J26.14, U21.5
RST_N: J2.6, U1.38, U3.1, U6.10
RST_N1: J8.6, U5.38, U8.10, U9.1
RST_N2: J14.6, U11.38, U13.10, U14.1
RST_N3: J20.6, U16.38, U18.10, U19.1
RST_N4: J26.6, U21.38, U23.10, U24.1
USBID/RB1: J8.7, J11.ID, R6.1, U5.41
USBID/RB2: J14.7, J17.ID, R18.1, U11.41
USBID/RB3: J20.7, J23.ID, R26.1, U16.41
USBID/RB4: J26.7, J29.ID, R34.1, U21.41
USBID/RB5: J2.7, J3.ID, R9.1, U1.41
VCAP: C4.1, C5.1, U1.7
VCAP1: C1.1, C21.1, U5.7
VCAP2: C27.1, C34.1, U11.7
VCAP3: C40.1, C47.1, U16.7
VCAP4: C53.1, C60.1, U21.7
