chipKIT32/RGB_Station/(commit log)

2017-11-17 Initial check in : v1.0 of board has been sent off for fab, not built or tested yet.
    [RGB_Station_v10.brd, RGB_Station_v10.sch, RGB_Station_v10_BOM_Microchip.xlsx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]
2017-11-25 Starting v1.1 of the board - changes listed in notes.txt
    [RGB_Station_v11.brd, RGB_Station_v11.sch, RGB_Station_v11_BOM_Microchip.xlsx]
2017-11-26 Updated switches with proper footprint.
    [RGB_Station_v11.brd, RGB_Station_v11.sch]
2017-11-26 Routed new switches, tweaked layout a bit - blue LED now on very end.
    [RGB_Station_v11.brd, RGB_Station_v11.sch]
2017-11-29 Added pin numbers to CLK and DAT output silk screen
    [RGB_Station_v11.brd]
2017-11-30 Version 1.1 complete and ready for fab.
    [RGB_Station_v11.GBL, RGB_Station_v11.GBO, RGB_Station_v11.GBP, RGB_Station_v11.GBS, RGB_Station_v11.GTL, RGB_Station_v11.GTO, RGB_Station_v11.GTP, RGB_Station_v11.GTS]
2017-12-03 Version 1.1 sent out for board fab.
    [RGB_Station_v11.GBL, RGB_Station_v11.GBO, RGB_Station_v11.GBP, RGB_Station_v11.GBS, RGB_Station_v11.GTL, RGB_Station_v11.GTO, RGB_Station_v11.GTP, RGB_Station_v11.GTS]
2017-12-14 Created v1.2 : fixed schematic problem with switches being always grounded.
    [RGB_Station_v12.brd, RGB_Station_v12.sch, RGB_Station_v12_BOM_Microchip.xlsx]
2017-12-16 Generated gerbers for v1.2
    [RGB_Station_v12.GBL, RGB_Station_v12.GBO, RGB_Station_v12.GBP, RGB_Station_v12.GBS, RGB_Station_v12.GTL, RGB_Station_v12.GTO, RGB_Station_v12.GTP, RGB_Station_v12.GTS]
2018-01-09 PDFs of schematics added for v1.1 and v1.2 boards.
2018-02-16 Updates to v1.2 : Made two screw terminals DNPs, and changed C2 from .1uf to 1uF to help with preventing resetting of PIC32 when RN does firmware update.
    [RGB_Station_v12.brd, RGB_Station_v12.sch, RGB_Station_v12_BOM_Microchip.xlsx]
2018-02-18 Updated v1.2 board for PCB:NG production - changed DRC rules to minimize violations. Updated .1uF cap and red LED with alternate parts. Updated USB footprint to be exactly correct for Wurth USB conne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
    [RGB_Station_v12.GBL, RGB_Station_v12.GBO, RGB_Station_v12.GBP, RGB_Station_v12.GBS, RGB_Station_v12.GTL, RGB_Station_v12.GTO, RGB_Station_v12.GTP, RGB_Station_v12.GTS]
2018-02-19 Updated U2 (level shifter) to alternate part that's available (same package, no board change).
    [RGB_Station_v12_BOM_Microchip.xlsx]
2018-02-19 Updated note on schematic about using open-drain reset controller, not push-pull.
    [RGB_Station_v12.brd, RGB_Station_v12.sch]
2018-02-27 Added centroid file
    [RGB_Station_v12_centroid.csv]
2018-02-28 Updated refdes for switches to SW1 and SW2.
    [RGB_Station_v12_BOM_Microchip.xlsx]
2018-03-07 Working on updating centroid/BOM to work with PCB:NG without errors/changes. Not there yet (four parts to fix)
    [RGB_Station_v12_BOM_Microchip.xlsx, RGB_Station_v12_centroid.csv]
2018-03-08 Finished centroid file for PCB:NG automation. Updated some library footprints.
    [RGB_Station_v12.brd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]
2018-03-14 Fixed PCB:NG CAM inner layer problem, regenerated gerbers. Far fewer DFM errors now. Still have minimum mask to mask distance errors though.
    [RGB_Station_v12.bottom_copper.gbr, RGB_Station_v12.bottom_mask.gbr, RGB_Station_v12.bottom_paste.gbr, RGB_Station_v12.bottom_silk.gbr, RGB_Station_v12.internal1.gbr, RGB_Station_v12.internal2.gbr, RGB_Station_v12.outline.gbr, RGB_Station_v12.top_copper.gbr]
2018-03-15 Got all PCB:NG DFM errors to go away - * Added large stop mask rectangles custom versions of USB, level shifter and PIC32 parts to fix stop mask too close errors * Fixed CAM file to include pads laye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
    [RGB_Station_v12.brd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]
2018-04-17 Starting work on RGB Station pin diagram
2018-04-18 More work on Pin diagram
2018-04-20 More work on pin diagram.
2018-04-21 Pin diagram - almost done.
2018-04-22 Done with pin diagram.
    [RGB_Station_v12.sch]
2018-04-24 Updated pin diagram to mention not to use 3.3V pin as power input if using LEDs.
